AntoineGuillemaud/Forest-s-Ears---Bioacoutic-project/README.md

# Foret's Ears
## A bioacoustic study in Brest, France
We have developed our own sound recorder for studying forest animal species (mostly birds).

And we have started (but not finished) the development of an algorithm for counting the number of call from each species in order to monitor the forest's biodiversity.

Check the PDF report for more info.

## Étude bioacoustique dans la vallée de Sainte-Anne du Portzic
Nous avons développé notre propre enregistreur audio pour étudier les espèces animales de la forêt (surtout des oiseaux).

Nous avons aussi commencé (mais pas terminé) le développement d'un algorithme pour compter le nombre de cris de chaque espèce pour pouvoir suivre l'évolution de la biodiversité de la forêt.

Consultez le rapport PDF pour plus d'informations.
