AntoineGuillemaud/Forest-s-Ears---Bioacoutic-project/code_enregistreurs/READ ME.txt

pour utiliser les enregistreurs, il faut mettre le code "TeensyDmaAdcLogger_embeded2" dans la teensy,

puis il faut transformer les fichiers ".bin" en ".wav" en utilisant changeBINwin.exe dans le meme dossier que les fichiers audio.
